TweakMunich/metricsinyourface/hardware/7SEG_BCD.PNG

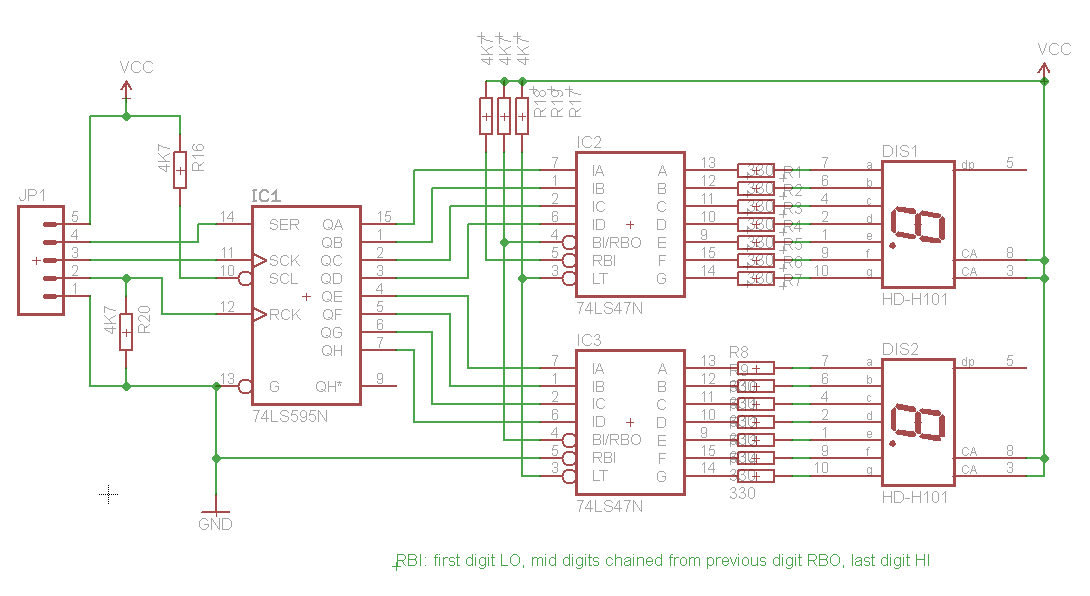
hardware/7SEG_BCD.PNG
