TweakMunich/metricsinyourface/hardware/7SEG_RAW.PNG

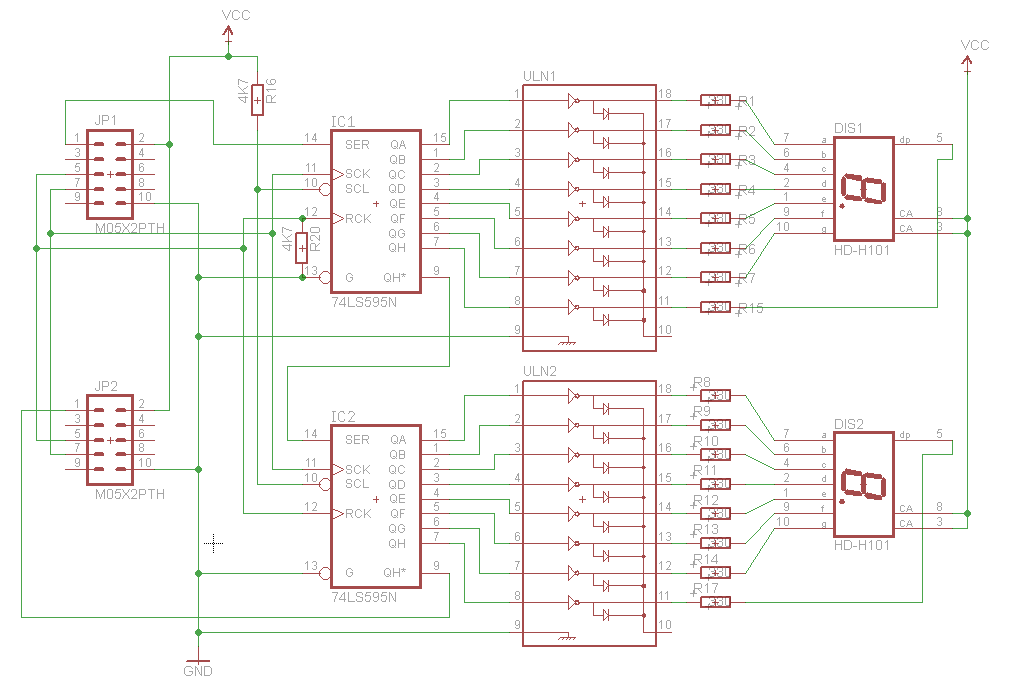
hardware/7SEG_RAW.PNG
