TweakMunich/metricsinyourface/hardware/readcfg.PNG

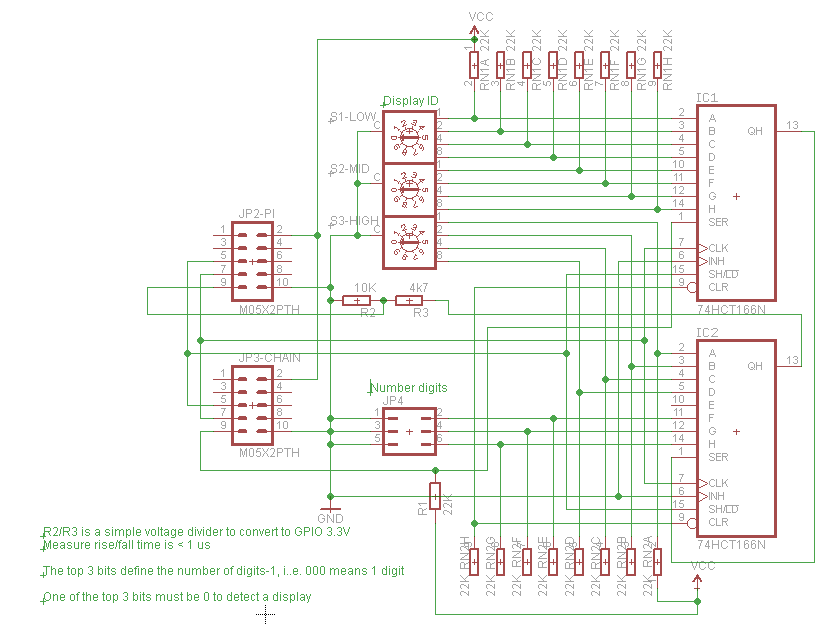
hardware/readcfg.PNG
