TweakMunich/metricsinyourface/(threads)

Thread 13 (2015-10-09):

Indicate on the 7-seg display if there are connection problems

spac3lord, 2015-10-09:
Either briefly blink the display on trouble.

Blink the decimal point if connection is there (works only if we drive 7seg directly as our current BCD decoder does not drive the decimal point)

Closed 2015-10-09.

Thread 15 (2015-10-18):

Assign ID's to Pi's that are transmitted querying. Can detecting dead Pi's.

spac3lord, 2015-10-18:

mdan1eli, 2015-12-28:
This is linked with #20.

Pi´s have an ID, their serial we can read in Python, I used it for registering on Mongo the sensor data

We could also update life-cycle so we register POST upon program start-up and deregister upon graceful shutdown.  This would let me detect which Pi´s exist and which should be alive.  I can move offline if they miss the heartbeat (which I measure with a filter on the server).  Could work?

spac3lord, 2016-01-02:
http://stackoverflow.com/questions/4271740/how-can-i-use-python-to-get-the-system-hostname

http://www.raspberrypi-spy.co.uk/2012/09/getting-your-raspberry-pi-serial-number-using-python/

I think just a heartbeat is good for start. Graceful shutdown will let you determien whether it was intentionally taken off-line or died. Catch is the current code has no graceful shutdown :-o

mdan1eli, 2016-01-03:
server side is expecting a header.  current iplementation uses hostname header, but could switch to different value.

Closed 2016-01-09.
