TweakMunich/metricsinyourface/(commit log)

2015-10-05 Eagle schamtic and picture of BCD to 7 seg decoder via shift reg
    [data_display_bcd.sch]
2015-10-07 Correction of agrs into args
    [app.py]
2015-10-08 Split bcd diver code from main app. prints usage on missing parameters
    [bcd.py, display_metric.py]
2015-10-09 7 segment driver with sofwtare decoder
2015-10-09 Fixed typo in comment
    [display_metric.py]
2015-10-10 New schematic for 7 segment driver with software decoding. Pull-down on Register clock to keep display clean at power-up
    [data_display_bcd.sch, data_display_raw.sch]
2015-10-10 Sample program to read config info from shift register
2015-10-18 10 pin socket similar to ISP connector Loop through of connector to allwo chaining of displays Read config input via PISO shift register
    [data_display_raw.sch, data_display_readcfg.sch]
2015-10-25 init sequence that shows display size was read correctly and displays IDs
    [display_metric.py, sevenseg.py]
2015-12-24 fake config reader with hard coded values to testing or use with i2c displays
2015-12-25 Support multiple i2c or shift register displays. Separate 7 segment formatting from device output.
2015-12-25 Comment for i2c setup
2015-12-28 Shift high byte before low byte (and high bit first) Repaced all resistors with 7.5mm spacing
    [data_display_raw.sch, data_display_readcfg.sch]
2015-12-31 Resistor voltage split for level conversion to GPIO 3.3V Highest 3 bits define length High register E not used
    [data_display_readcfg.sch]
2016-01-09 Allow floating point numbers and text to be displayed (within limits of what a 7-seg display can do). No longer treat values as numbers.
    fixes #19
    [display_metric.py]
2016-01-09 Ignore non-printable characters. Allow degree symbol for temp displays.
2016-01-09 Send hostname in REMOTE_HOST header Do not abort on 404 error Prep for using new REST api (can be uncommented when server pushed)
    [display_metric.py]
2016-06-04 adjusted i2c seven seg to use new Adafruit libraries
2016-06-04 change default to use i2c display and fake channel as that's the most common setup now
2016-06-05 read config data from chain of MCP23017 on I2C bus
2016-07-09 fixed indent (github browser edit is NG)w
    [display_metric.py]
2016-08-05 catch and raise connection errors to avoid abort during timeout
    [display_metric.py]
2016-08-05 set shorter connection timeout
    [display_metric.py]
2016-08-09 catch socket.timeout
2016-08-20 fixed old method call. now theer is only one make_displays method
    [display_metric.py]
2016-08-20 reverted fake to default of 4 digit display
    [readconfig_fake.py]
2016-09-28 handle strings, error check
    [bargraph_i2c.py]
2016-10-15 extract difference between i2c and serial into Displays class. Manage multiple i2c with addresses. Don't abort in i2c error
    [bargraph_i2c.py, display_i2c.py, display_metric.py, readconfig_fake.py, sevenseg_i2c.py]
2016-10-15 invert logic on config data fetch
    [display_metric.py]
2016-10-15 fixed call to make_displays on config change
    [display_metric.py]
2016-10-15 added comment. default back to fake config and i2c display
2016-10-15 expremiental stepper driver
